gepito/PlantCare/data/0806-paprika/log.md

20240706 10.00, "much pumped, dump log, sensor cleaning"
