gepito/PlantCare/data/1013-heatup/heatup.png

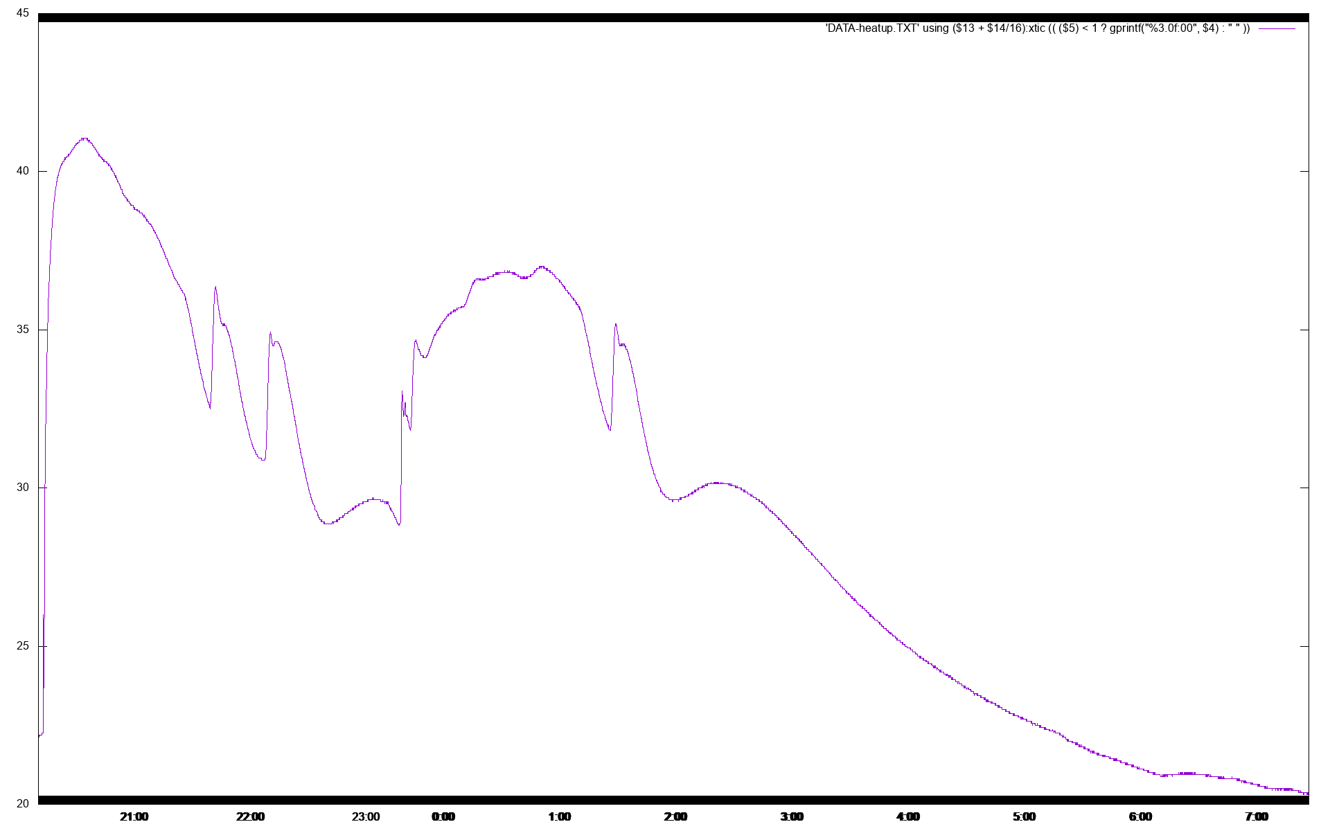
data/1013-heatup/heatup.png
