gepito/PlantCare/doc/block-diagram.drawio.png

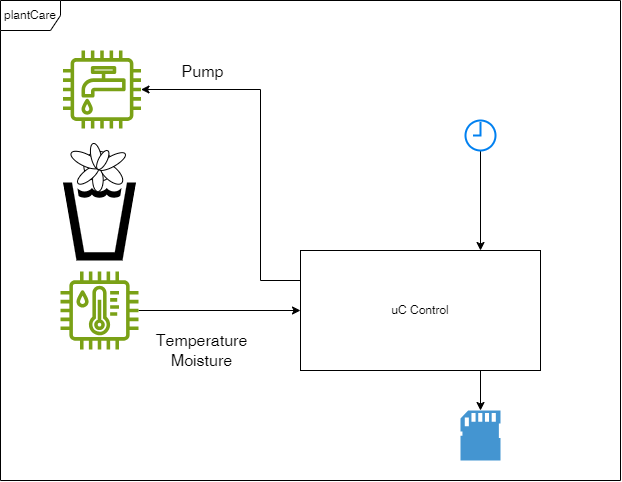
doc/block-diagram.drawio.png
