gepito/PlantCare/Hardware/pcb/main/main-wleonardo.pdf

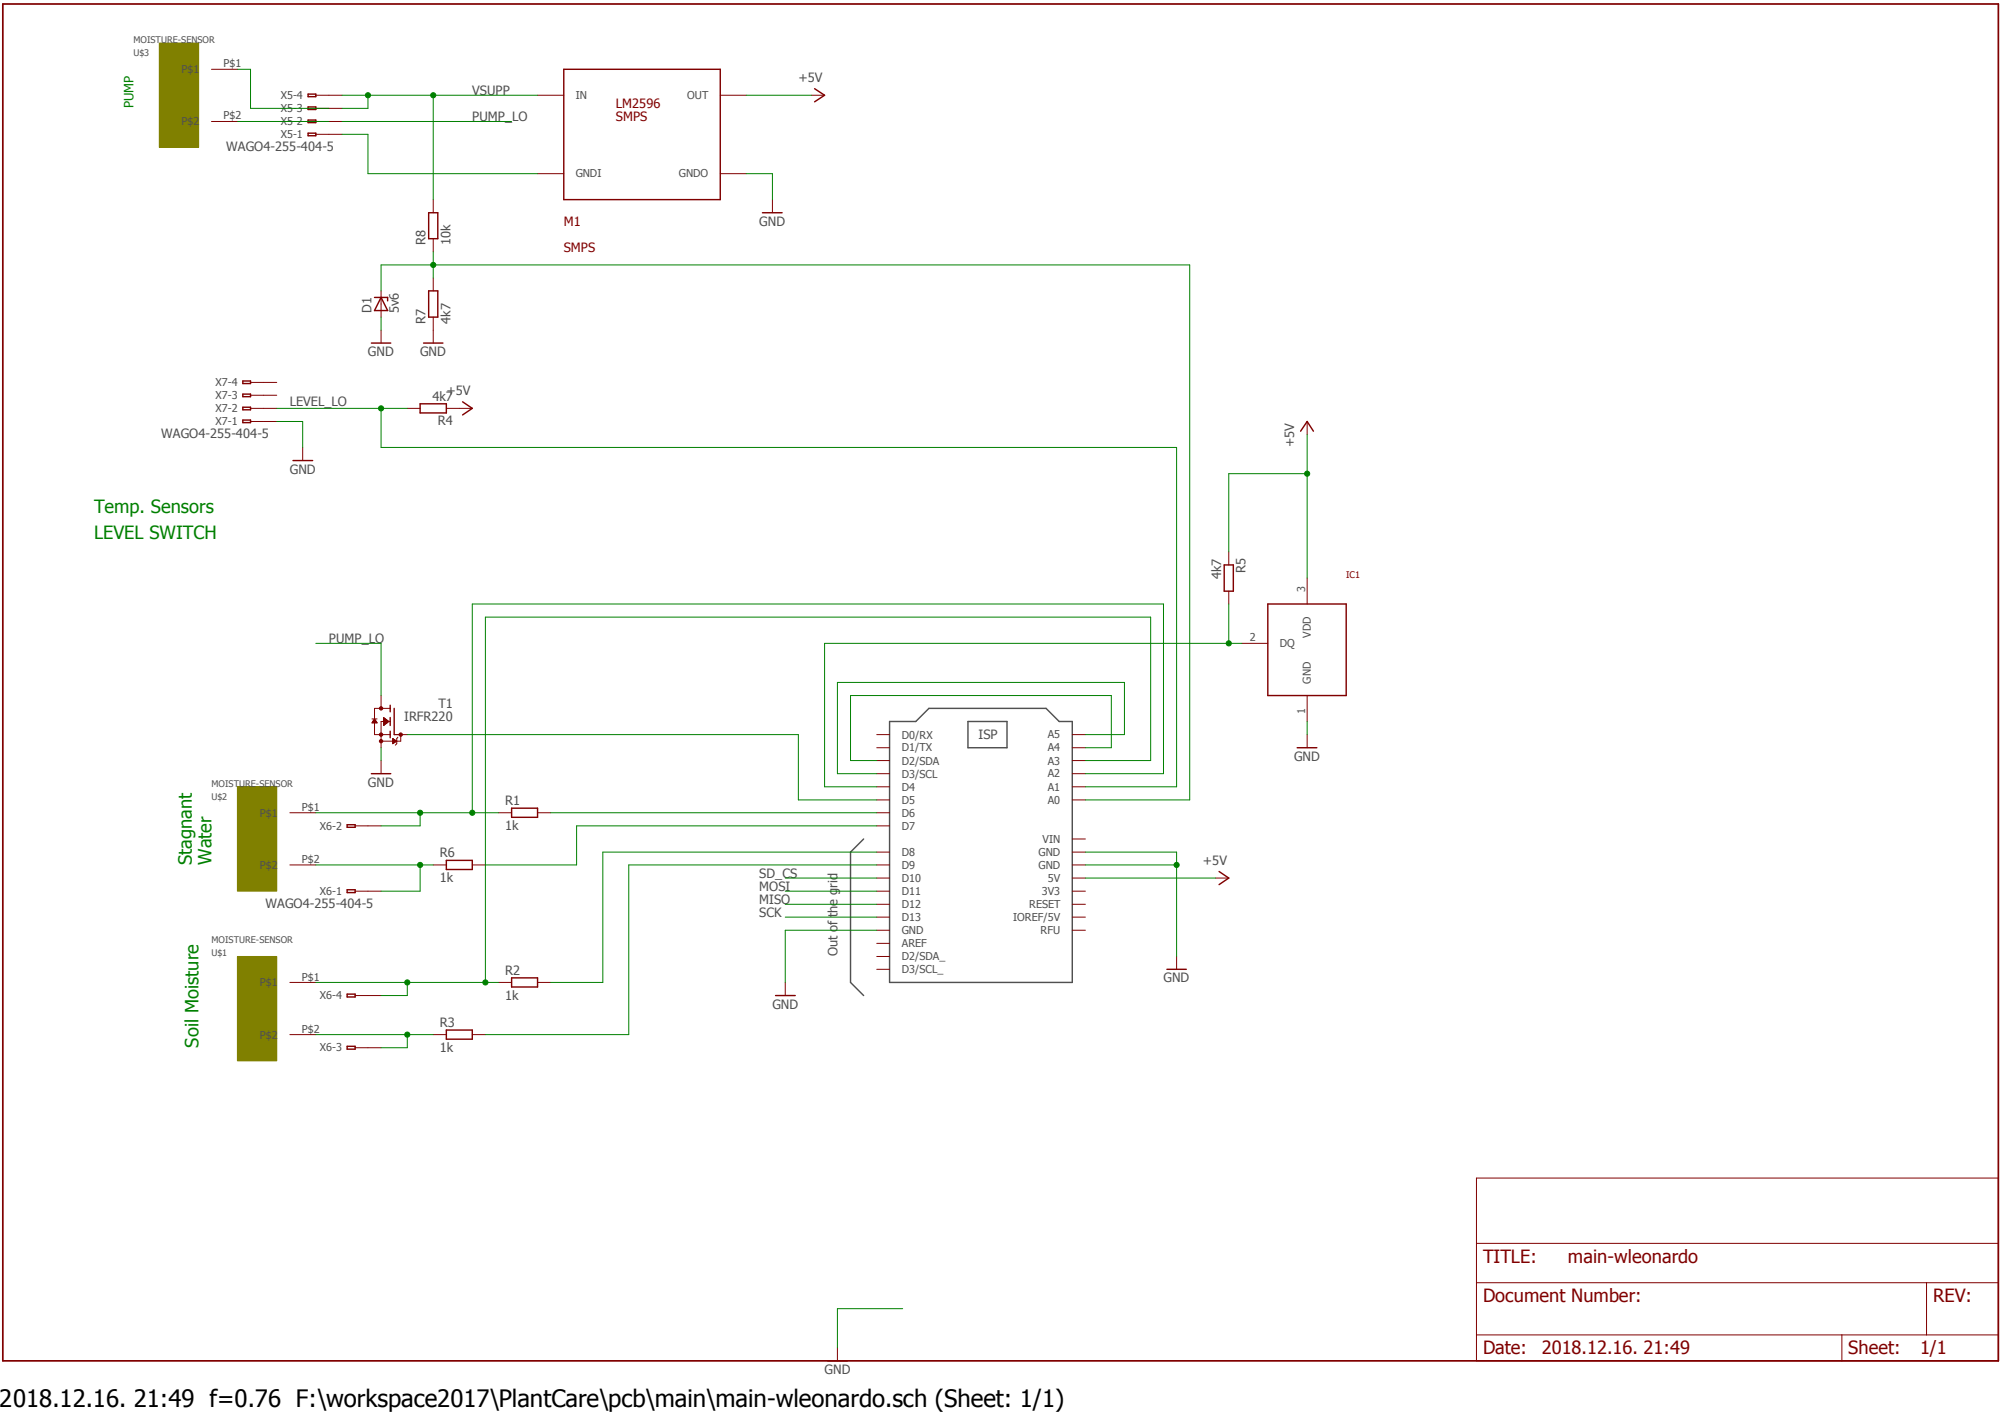
[picture p3: page 1]

Out of the grid

Document Number: | REV:

Date: 2018.12.16. 21:49 | Sheet: 1/1

2018.12.16. 21:49 f=0.76 F:\workspace2017\PlantCare\pcb\main\main-wleonardo.sch (Sheet: 1/1)
