gepito/PlantCare/Hardware/pcb/main/main.pdf

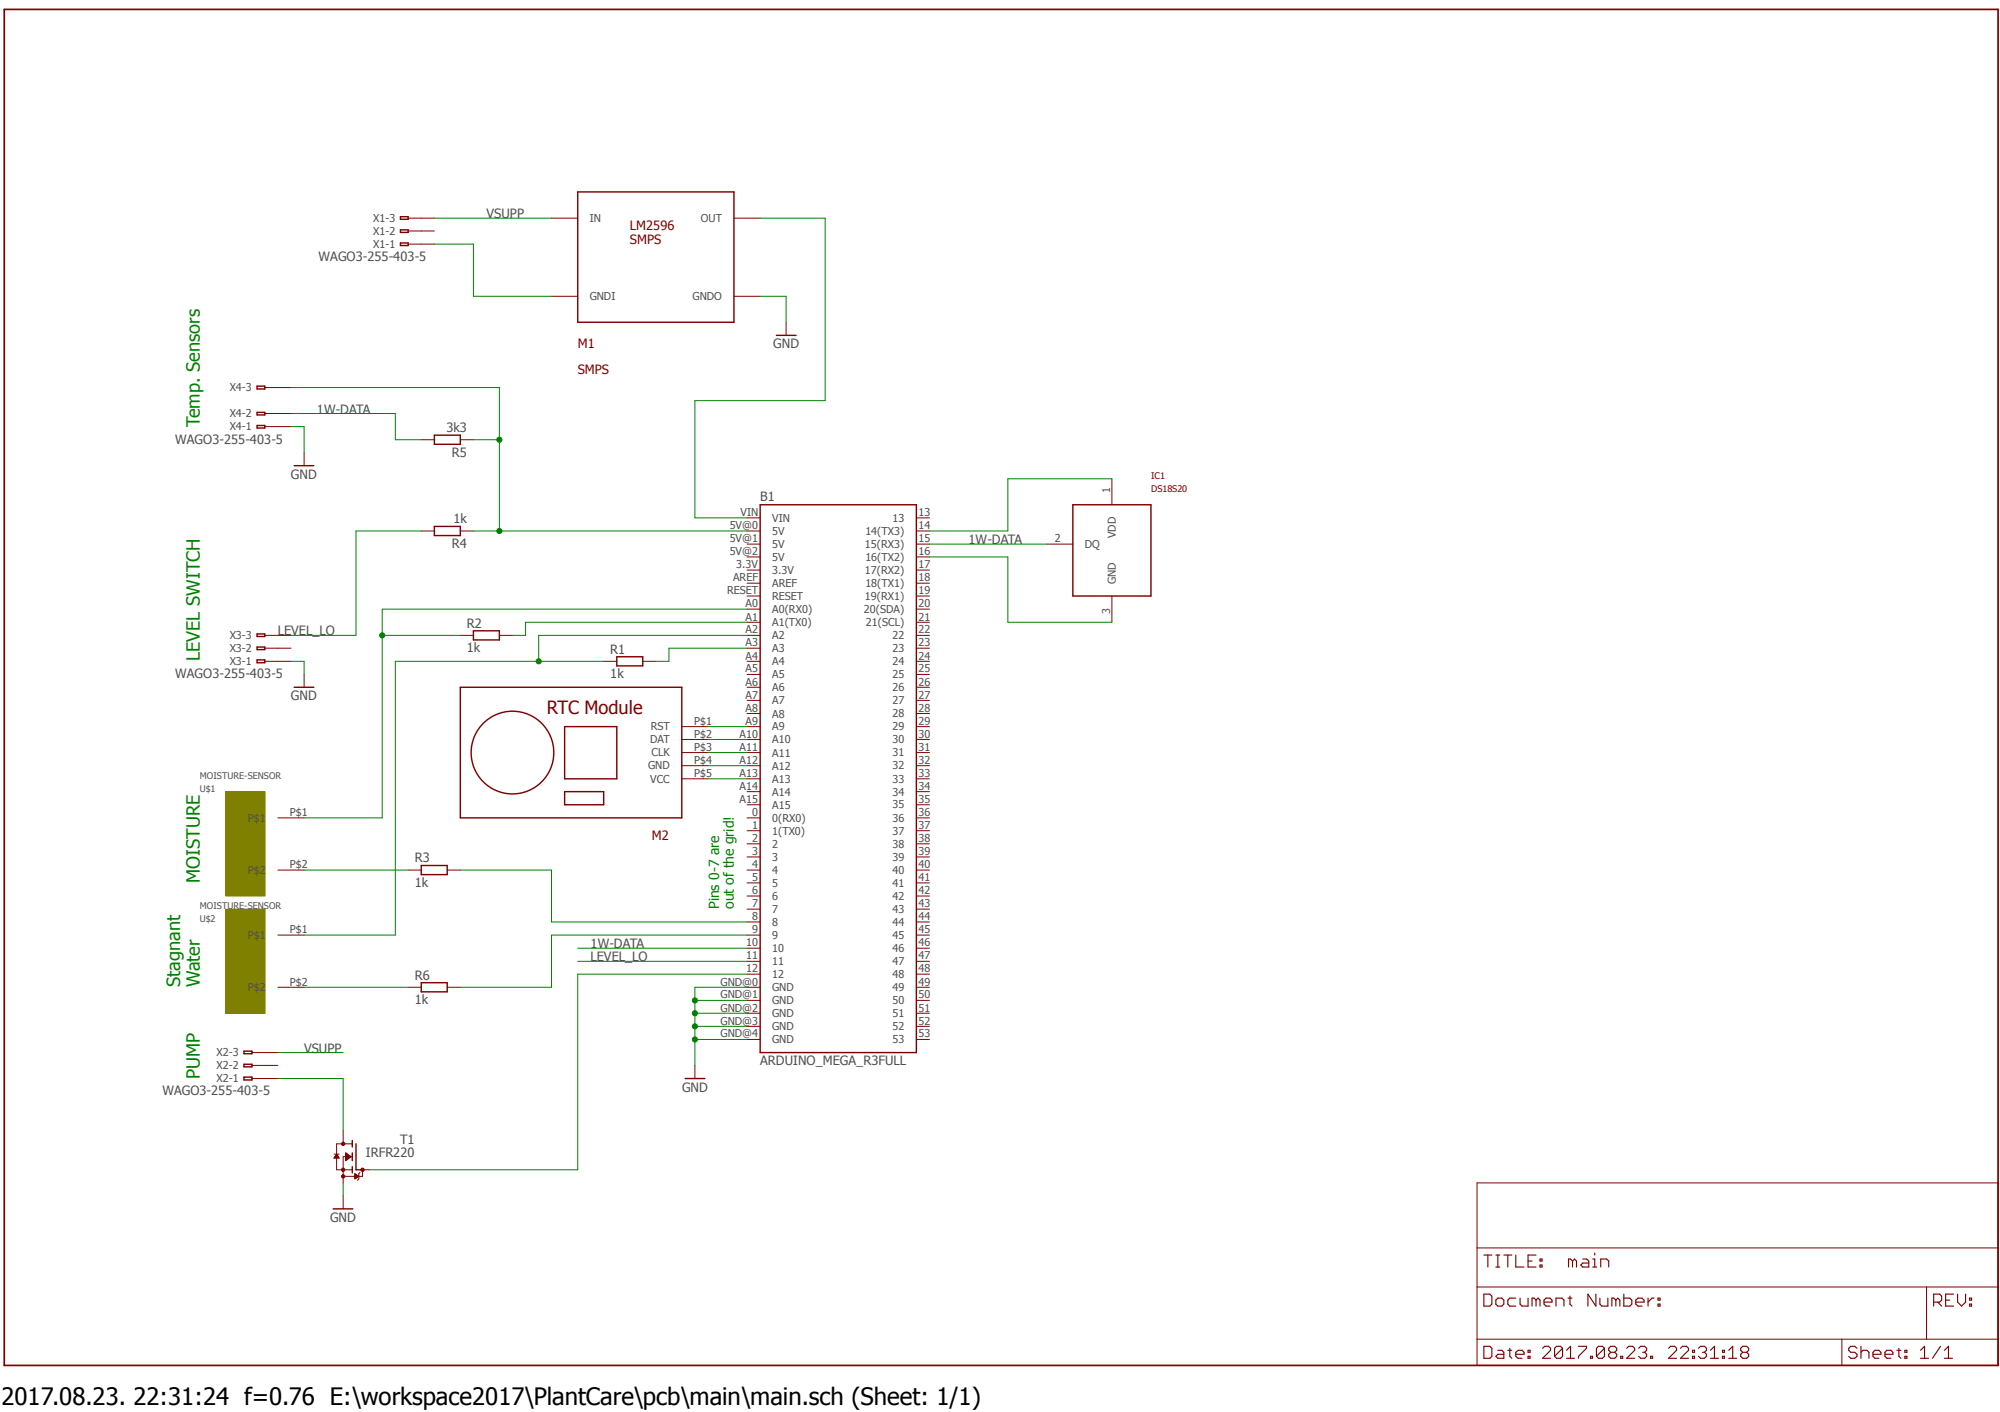
[picture p4: page 1]
ARDUINO_MEGA_R3FULL; WAGO3-255-403-5; GND; IRFR220; RESET RESET; GND GND@4; GND GND@0 GND GND@1 GND GND@2 GND GND@3; 5V 5V@2 3.3V 3.3V AREF AREF; 21(SCL); 21 20(SDA); VIN VIN; OUT; GNDI; GNDO; VDD; MOISTURE-SENSOR; VCC; P$5 GND; P$4 CLK; P$3 DAT; P$2 RST; 1W-DATA; VSUPP; LEVEL_LO; SMPS; LM2596 SMPS; RTC Module; Stagnant; Water; Pins 0-7 are

PUMP MOISTURE LEVEL SWITCH Temp. Sensors

out of the grid!

2017.08.23. 22:31:24 f=0.76 E:\workspace2017\PlantCare\pcb\main\main.sch (Sheet: 1/1)
