gepito/PlantCare/Hardware/doc/simulation/failsafe-switching.asc

M1: nmos; IRF1404
M2: nmos; IRF1404
R1: res; 55
R2: res; 100k
R3: res; 100k
R4: res; 10k
V1: voltage; 15; Rser=11m
V2: voltage; PULSE(0 4.4 10u 1u 1u 50u 150u 2)
V3: voltage; PULSE(0 4 35u 1u 1u 50u 100u 2)
Named nets: 0, g1, g2, ds
.tran 1000u
Note that the operation of the load is ivariant to the order of switching FETs
R4 allows for M2 FET sanity check via measuring U(ds)
