gepito/PlantCare/Hardware/pcb/main/main-wleonardo.brd

## EAGLE design Hardware/pcb/main/main-wleonardo.brd (2020-08-20)

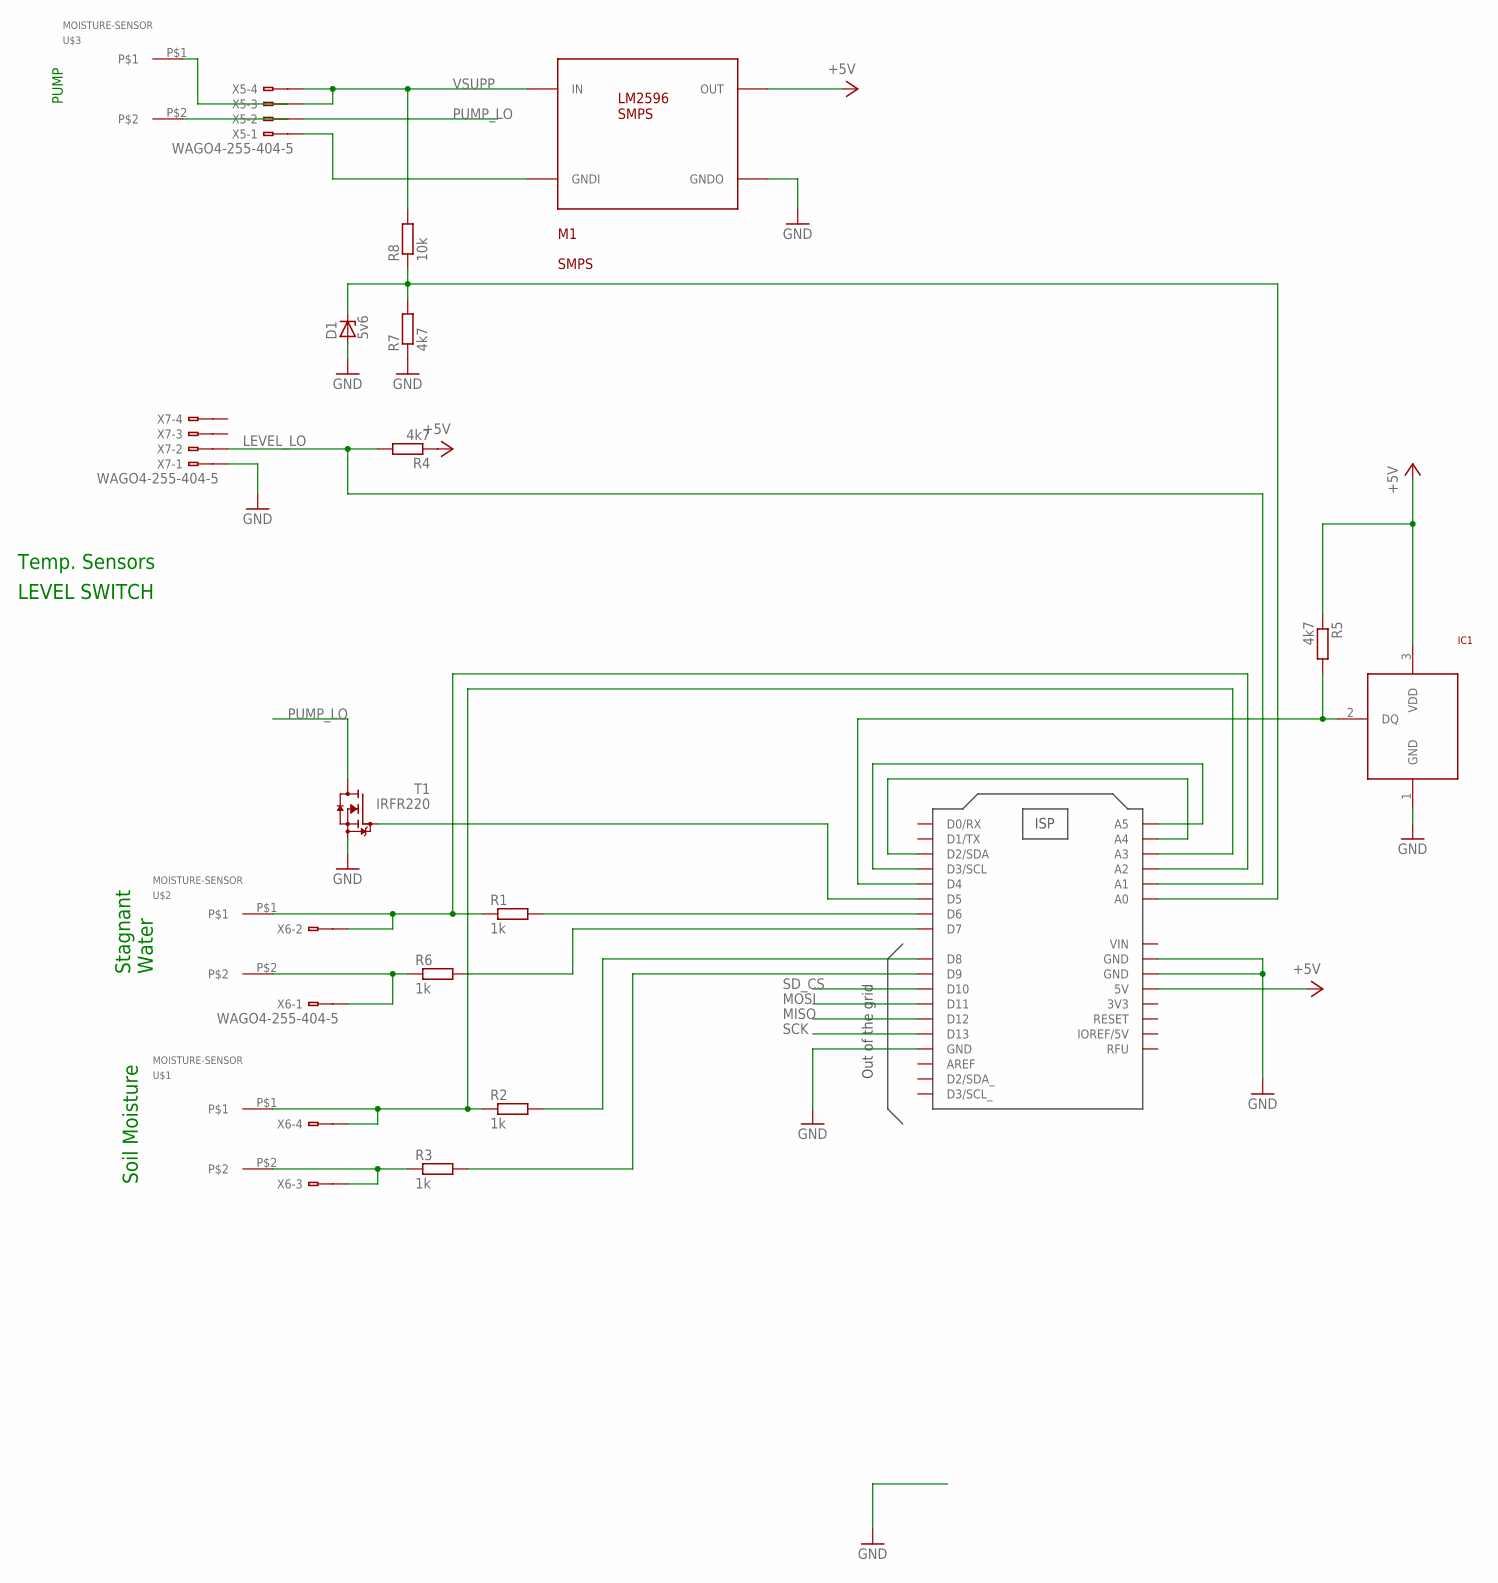
[picture p5: schematic main-wleonardo.sch]

Parts:
D1: 5v6; SOT23
IC1: PAPP_DS1820; PAPP_TO92-
LEONARDO: SPARKFUN-BOARDS_ARDUINO-LEONARDO-OUTLINE; SPARKFUN-BOARDS_ARDUINO_R3
M1: SMPS; SMPS-1
R1, R2, R3, R6: 1k; R0805
R4, R5, R7: 4k7; R0805
R8: 10k; R0805
T1: IRFR220; TO252
U$1, U$2, U$3: MOISTURE-SENSOR
X5, X6, X7: WAGO4-255-404-5; 255-404-5

Connections:
1W-DATA: IC1.2 (DQ), LEONARDO.D4, R5.2
+5V: IC1.3 (VDD), LEONARDO.5V, M1.P$7 (OUT), M1.P$8 (OUT), R4.1, R5.1
GND: D1.1 (A), IC1.1 (GND), LEONARDO.GND@1 (GND), LEONARDO.GND@2 (GND), LEONARDO.GND@3 (GND), M1.P$5 (GNDO), M1.P$6 (GNDO), R7.1, T1.2 (S), X7.B1
LEVEL_LO: LEONARDO.A1, R4.2, X7.B2 (B1)
MISO: LEONARDO.D12
MOSI: LEONARDO.D11
unnamed: LEONARDO.D5, T1.1 (G)
unnamed: M1.P$1 (GNDI), M1.P$2 (GNDI), X5.B1
unnamed: R6.1, U$2.P$2, X6.B1
unnamed: LEONARDO.D6, R1.2
unnamed: D1.3 (C), LEONARDO.A0, R7.2, R8.1
unnamed: R3.1, U$1.P$2, X6.B3 (B1)
unnamed: U$3.P$2, X5.A2 (A1)
unnamed: U$3.P$1, X5.A3 (A1)
unnamed: LEONARDO.A2, R1.1, U$2.P$1, X6.B2 (B1)
unnamed: LEONARDO.D7, R6.2
unnamed: LEONARDO.A3, R2.1, U$1.P$1, X6.B4 (B1)
unnamed: LEONARDO.D9, R3.2
unnamed: LEONARDO.A4, LEONARDO.D2 (D2/SDA)
unnamed: LEONARDO.A5, LEONARDO.D3 (D3/SCL)
unnamed: LEONARDO.D8, R2.2
PUMP_LO: T1.3 (D), X5.B2 (B1)
SCK: LEONARDO.D13
SD_CS: LEONARDO.D10
VSUPP: M1.P$3 (IN), M1.P$4 (IN), R8.2, X5.B3 (B1), X5.B4 (B1)

Notes on the sheet:
Soil Moisture
LEVEL SWITCH
Temp. Sensors
Stagnant Water
PUMP

Board: 2 copper layers, 19 parts (0 on the bottom side), 21 nets, no tracks yet.
