gepito/PlantCare/(commit log)

2020-08-20 Files imported from local working directory
    [main-wleonardo.brd, main-wleonardo.sch, main.sch]
2020-11-01 Plotting scripts added
    Irrelevant scripts deleted
    House heat-up data added with plot
2025-11-23 data consolidation
    data caption added
    [240806-herend-DATA.ods]
2025-11-23 data consolidation
    [240806-herend-DATA.ods]
2025-12-14 space separated files added
    python csv reader example
    [240806-herend-diff.TXT]
